Lakshmikanthaks/Smart-Baby-Bed/README.md

# Smart-Baby-Bed
Designed by NIE IAR students. Ajit N.N, Keshav Prakash &amp; Rakesh K.M
